bhorling/stained-glass/examples/test2.stl

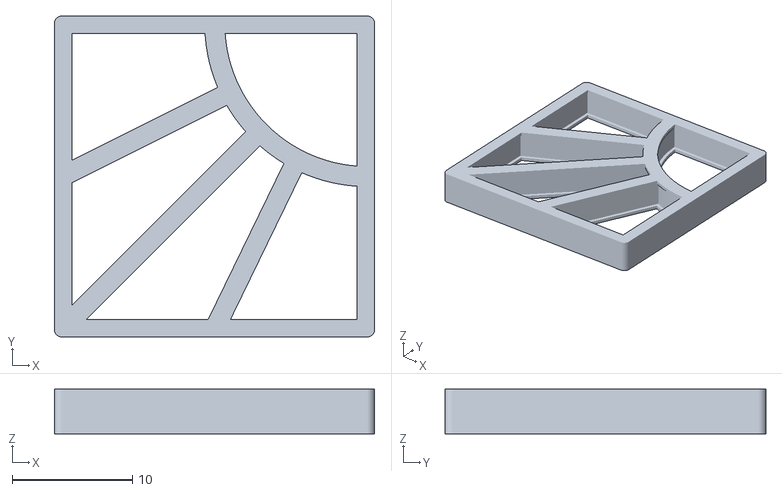
[picture p1: CAD file, 2026-11-08]
examples/test2.stl
26.6 x 26.7 x 3.70
