bhorling/stained-glass/examples/test.stl

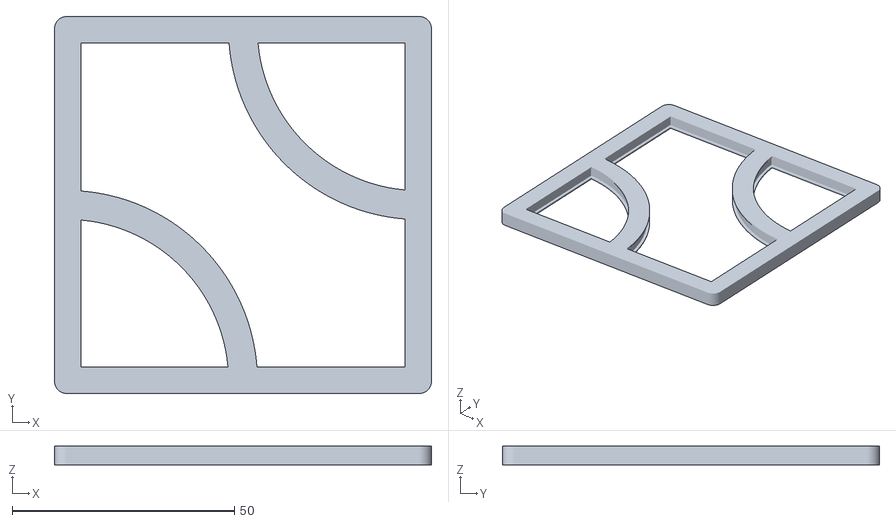
[picture p2: CAD file, 2026-11-08]
examples/test.stl
84.9 x 84.9 x 4.25
