bhorling/stained-glass/(commit log)

2026-11-08 Initial commit: OpenSCAD stained-glass generator, presets, and examples
    [stained-glass.scad, test.stl, test2.stl]
2026-11-08 Add multi-thickness support and switch to stained-glass.json.example for local preset isolation
    [stained-glass.scad]
2026-11-08 Allow free-form path input for glass_svg in Customizer
    [stained-glass.scad]
